11philip22/rp2040-custom-minimal/README.md

# RP2040 Minimal Project for KiCad

This repository contains a modified version of the Raspberry Pi RP2040 Minimal design for KiCad.

The RP2040_minimal-edit_V3 design by [Gerald](https://community.element14.com/members/geralds) retains the original PCB outline and GPIO connectors, with an improved layout, 0603 parts instead of 0402, a USB-C connector instead of Micro USB, and improved ESD protection.

## Schematic

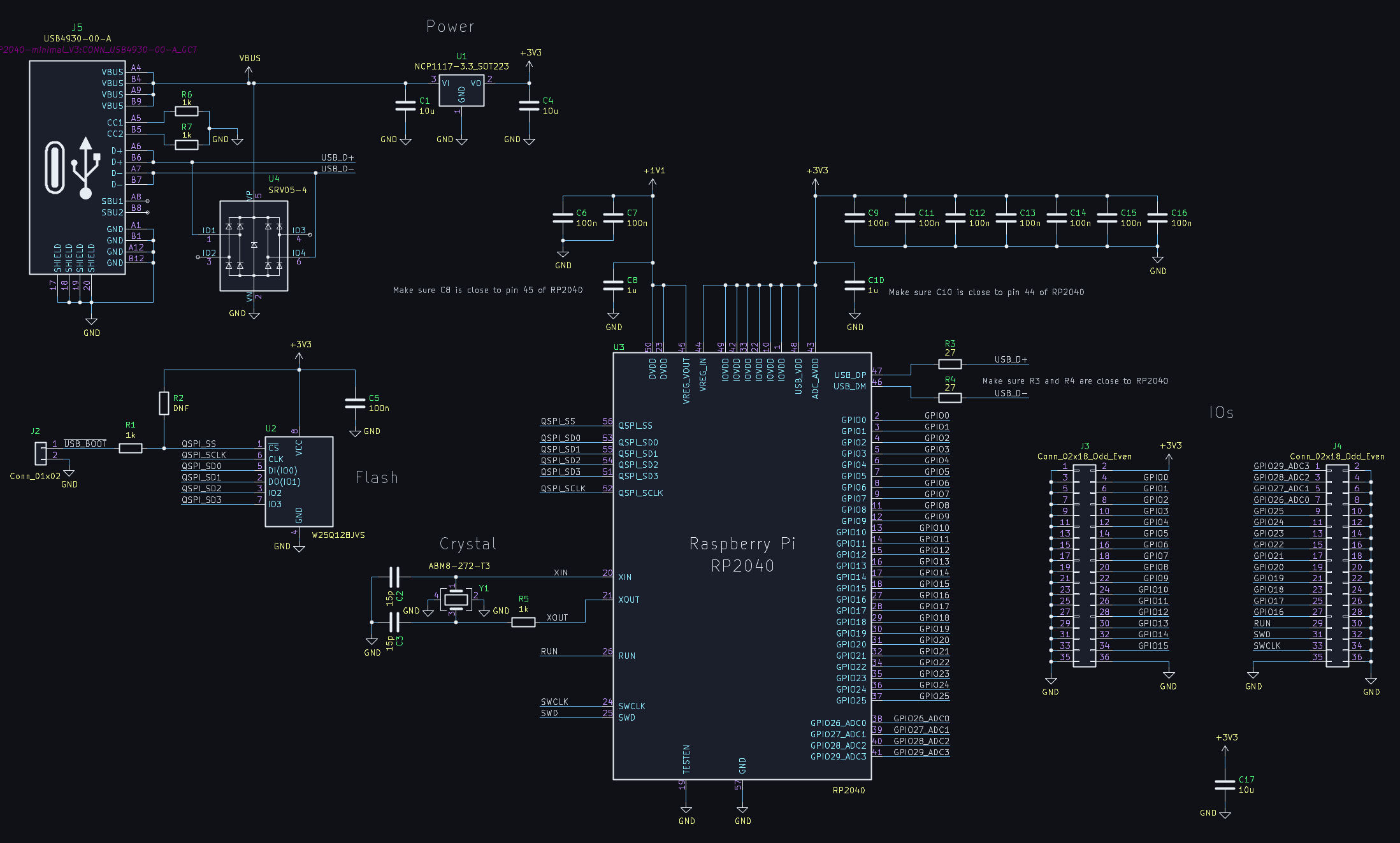
[picture p1: images/RP2040-minimal-Rev3_sch.png]
Schematic


## PCB Layout

The image here shows the top side copper.

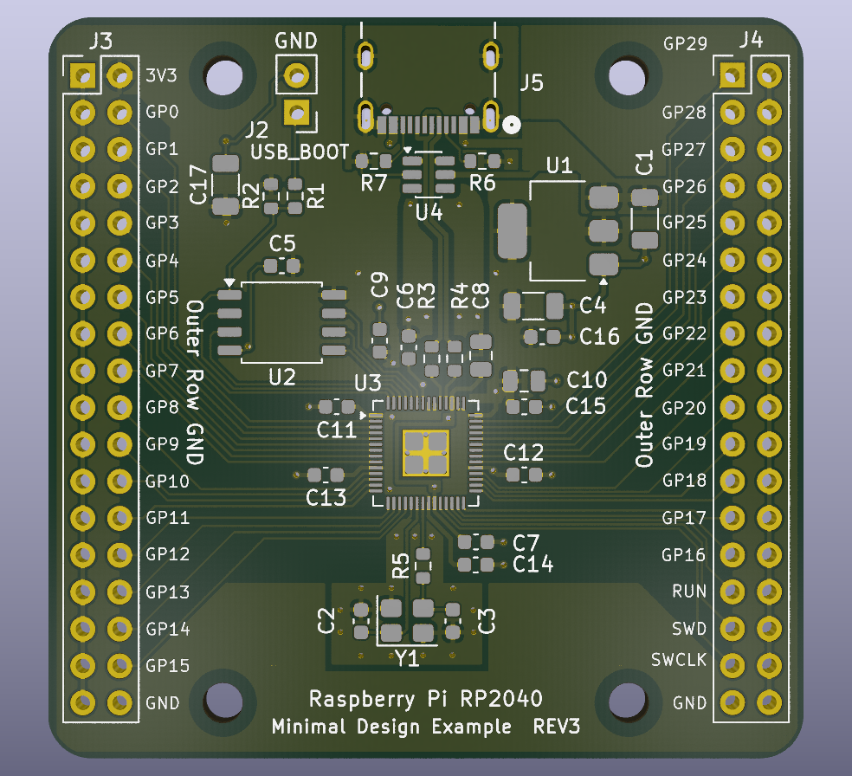
[picture p2: images/minimal-edit_V3_3D_topnc.png]
Top-side PCB layout


Underside:

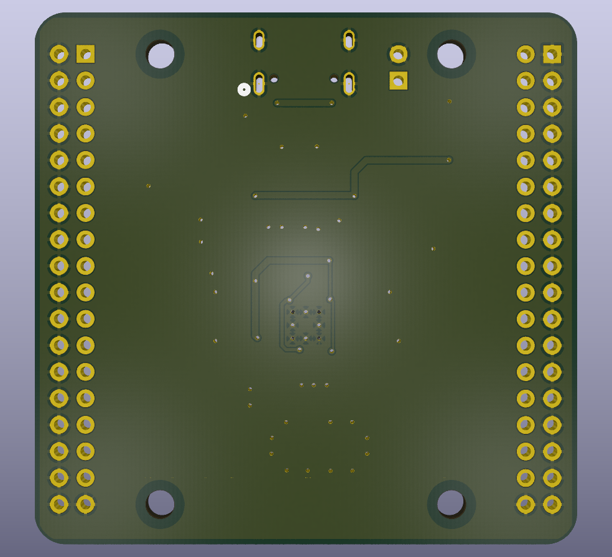
[picture p3: images/minimal-edit_V3_3D_botnc.png]
Bottom-side PCB layout


## 3D Render

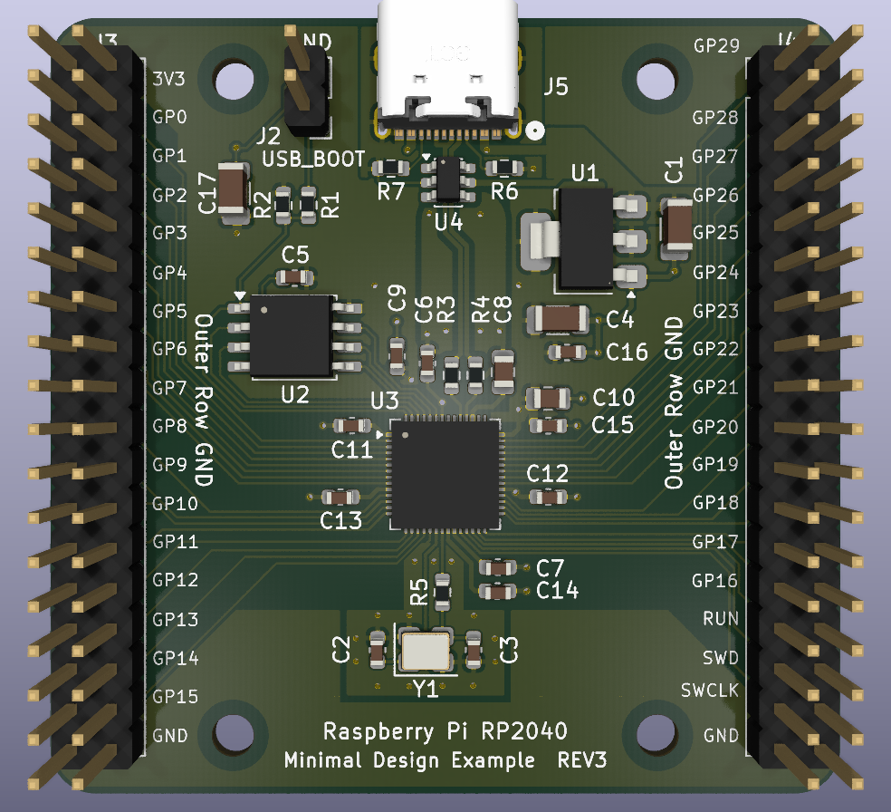
[picture p4: images/minimal-edit_V3_3D_top.png]
Top-side 3D render


Underside:

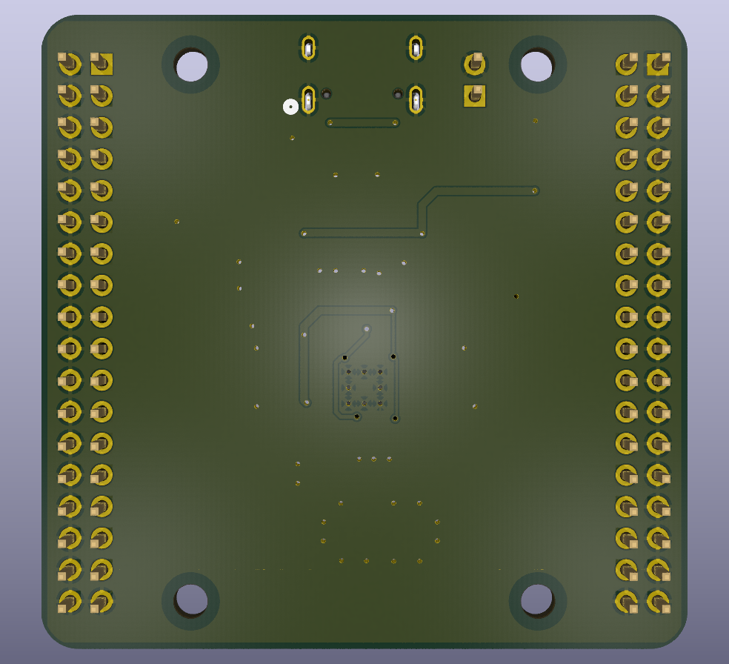
[picture p5: images/minimal-edit_V3_3D_bot.png]
Bottom-side 3D render
