11philip22/rp2040-custom-minimal/(commit log)

2026-11-11 chore: update bom
    [G73 button.STEP, USB4085-GF-A.stp, USB4930-00-A.stp, bom.csv, custom_pico_minimal.kicad_pcb, custom_pico_minimal.kicad_sch, designators.csv, minimal-edit_V3.kicad_pcb]
2026-11-11 chore: remove prod files from repo
    [bom.csv, designators.csv, positions.csv]
2026-11-11 fix(pcb): align GP29 silkscreen with adjacent labels
    [minimal-edit_V3.kicad_pcb]
2026-11-11 fix(pcb): board edges
    [minimal-edit_V3.kicad_pcb]
2026-11-11 fix(pcb): mark R2 as do not populate in schematic and board
    [minimal-edit_V3.kicad_pcb, minimal-edit_V3.kicad_sch]
2026-11-11 fix(pcb): match J5 footprint and 3D model to LCSC C2988369
    [minimal-edit_V3.kicad_pcb, minimal-edit_V3.kicad_sch]
2026-11-11 fix(pcb): repair symbol library links and assembly exclusions
    - Register the project symbol library and sync cached footprint references
    - Exclude hand-soldered headers and mounting holes from BOM and placement files
    - Normalize project file line endings
    [minimal-edit_V3.kicad_pcb, minimal-edit_V3.kicad_sch]
2026-11-11 chore(pcb): sync J5 pin metadata from schematic
    [minimal-edit_V3.kicad_pcb]
2026-11-12 fix(pcb): replace Y1 with C133334 and match load capacitors
    [minimal-edit_V3.kicad_pcb, minimal-edit_V3.kicad_sch]
